anhtn1980/TNN-Smart-Control/(commit log)

2026-05-23 đưa file từ máy tính lên
2026-05-27 fix: stabilize relay status stream and parsing between ESP and Mega
    [Code_ArduinoMEGA2560_W5500_TCP_Max485_.ino, Code_ESP32_Web_UI_TCP_client_.ino]
2026-05-27 perf: reduce UI command cooldown for faster consecutive button presses
2026-05-28 fix: make relay taps smoother with optimistic state command flow
    [Code_ArduinoMEGA2560_W5500_TCP_Max485_.ino, Code_ESP32_Web_UI_TCP_client_.ino]
2026-06-18 Add initial changelog for firmware versions
    Added changelog for TNN Smart Control firmware updates, detailing improvements and version history for both Arduino MEGA and ESP32 components.
2026-06-18 Enhance HTTP request handling and firmware versioning
    Updated firmware version and improved HTTP request handling with a timeout mechanism. Adjusted reconnection frequency and delays for better stability.
    [Code_ESP32_Web_UI_TCP_client_.ino]
2026-06-20 Bump firmware version to 1.3.0 and enhance relay sync
    Updated firmware version to 1.3.0 and improved state synchronization for relay commands.
2026-06-20 Rollback changes in v1.2.0 for improved responsiveness
    Rollback changes from v1.2.0 due to issues with physical switch mirroring logic and response delays. Adjustments made to improve responsiveness and remove blocking behavior in the ESP32 web client.
2026-06-20 Bump version to 1.4.0 and fix relay button issues
    Updated version to 1.4.0 and fixed relay button responsiveness issues. Added pendingTarget tracking and improved status synchronization.
2026-06-20 Update Changelog for version 1.5.0 enhancements
    Triển khai HTTP keep-alive để cải thiện kết nối ESP32 tới MEGA. Thêm nhiều cải tiến như quản lý kết nối và xử lý yêu cầu web.
2026-06-23 them logic 4 nut dieu hoa voi LOGO
2026-06-24 feat(esp32): v2.1.0 — trang /modbus điều khiển 4 điều hòa qua LOGO! 8
    - Đổi logoPort từ 502 → 504 (port riêng cho hệ thống TNN)
    - Thêm readACFeedback(): FC1 Read Coils V0.0-V0.3 cập nhật acSnapshot
    - Thêm route GET /ac/toggle?ch=0..3: gọi logoSendPulse(), trả JSON
    - Thêm route GET /ac/status: đọc feedback thật, trả {"ac":[0,1,0,0]}
    - Thay trang /modbus placeholder bằng UI hoàn chỉnh: 4 nút ĐH1-ĐH4,
    trạng thái thật từ LOGO!, cooldown 1.6s, poll 2 giây
    Claude-Session: https://claude.ai/code/session_01GHmGa9BQc2wq6tp54nUGxA
2026-06-24 feat(esp32): v2.2.0 — trang /amx CE-IO4 + CE-REL8, cải tổ menu
    Menu:
    - Xóa trang /logo (iframe LOGO! Web Editor)
    - Đưa /modbus lên vị trí 2, đổi tên thành "Điều khiển Điều hòa (LOGO!)"
    - /amx nay có UI và backend thật
    AMX (CE-IO4 port 44197 + CE-REL8 port 44197):
    - amxMultiQuery(): connect-per-transaction, gửi nhiều lệnh, đọc nhiều dòng
    - amxReadInputs(): Subscribe /io/N/digitalInput → cập nhật amxInputSnapshot
    - amxReadRelays(): Subscribe /relay/N/state → cập nhật amxRelaySnapshot
    - amxSetRelay(ch, val): set /relay/N/state true|false + optimistic update
    - amxMirrorInputs(): khi IO thay đổi → toggle relay tương ứng (kèm mirror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
2026-06-24 config(esp32): cập nhật IP AMX thực tế
    CE-IO4 → 192.168.1.203
    CE-REL8 → 192.168.1.204
    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
2026-06-24 feat(esp32): v2.3.0 — trang KIOS, info panel, AMX mirror flag
    - Thêm trang /kios "Truy cập trang KIOS" (hàng 4)
    Trang KIOS (/kios):
    - Nhập URL + nhấn Enter hoặc ▶ Truy cập → nhúng iframe
    - Lưu URL vào localStorage (nhớ qua lần sau)
    - Preset nhanh: LOGO! Web Editor, MEGA, ESP32 Menu
    - Nút mở tab mới + tải lại
    AMX mirror flag (amxMirrorEnabled):
    - Mặc định false — Kramer đang quản lý công tắc tường (giai đoạn 1)
    - Bật/tắt qua UI nút "Bật Mirror" / "Tắt Mirror" trên trang /amx
    - Route GET /amx/mirror?enable=true|false
    - /amx/status trả thêm field mirrorEnabled
    Info panel (ℹ️ Thông tin) trên các trang:
    - /mega: ki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
2026-06-24 fix(kios): cải tổ UI trang KIOS — 3 nút site, ẩn URL bar
    - Xóa preset cũ (LOGO!/MEGA/ESP32)
    - 3 nút mới: KC-Brain (192.168.1.236:8000), SL-240C (192.168.1.215:8000),
    "＋ Nhập trang mới" (toggle URL input bar)
    - URL bar ẩn mặc định, chỉ hiện khi bấm "Nhập trang mới"
    - Mặc định mở KC-Brain khi vào trang
    - Nút 🔄 tải lại gọn trong top bar
    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
    [Code_ESP32_Web_UI_TCP_client_.ino]
2026-06-24 fix(kios): xóa dòng hint thừa về đăng nhập iframe
    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
    [Code_ESP32_Web_UI_TCP_client_.ino]
2026-06-24 fix(amx): sửa 2 bug mirror từ Codex review
    P1 — Seed amxLastInputs khi bật mirror:
    Khi chuyển amxMirrorEnabled false→true, nếu một số công tắc
    tường đang HIGH, amxLastInputs=0 khiến poll đầu tiên coi tất cả
    input đang HIGH là "thay đổi mới" và toggle relay sai.
    Fix: amxLastInputs = amxInputSnapshot ngay tại thời điểm bật.
    P2 — Đồng bộ _mirror từ server trong poll():
    Biến JS _mirror khởi tạo false cứng. Nếu server đang mirrorEnabled=true
    (qua reboot hoặc tab khác bật), lần bấm đầu tiên gửi enable=true thay vì
    enable=false, khiến không thể tắt được mirror.
    Fix: _mirror = !!d.mirrorEnabled mỗi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
    [Code_ESP32_Web_UI_TCP_client_.ino]
2026-06-24 fix(amx): ẩn info panel mặc định — thiếu display:none trong CSS
    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
    [Code_ESP32_Web_UI_TCP_client_.ino]
2026-06-24 fix(amx): bỏ AMX polling trong loop() khi mirror TẮT
    Khi amxMirrorEnabled=false (mặc định, Kramer đang chạy), amxReadInputs()
    vẫn được gọi mỗi 500ms và block 400ms chờ timeout vì AMX device chưa
    kết nối thật. Hệ quả: loop() bị chiếm ~80% thời gian, server.available()
    không được gọi kịp → ERR_CONNECTION_REFUSED khi navigate.
    Fix: chỉ poll AMX trong loop() khi amxMirrorEnabled=true. IO status vẫn
    được đọc on-demand qua /amx/status khi browser poll trang AMX.
    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
    [Code_ESP32_Web_UI_TCP_client_.ino]
2026-06-24 fix(amx): v2.4.0 — persistent connection CE-IO4, non-blocking IO poll
    Subscribe của AMX CE-IO4 không hoạt động one-shot trên connection mới
    (thiết bị chỉ push khi có thay đổi, không trả response ngay). Chuyển
    sang mô hình persistent connection:
    - amxIoClient: EthernetClient giữ lâu dài với CE-IO4
    - amxIoConnect(): connect + gửi 4 Subscribe lệnh, CE-IO4 sẽ gửi
    trạng thái hiện tại ngay rồi push mỗi khi công tắc thay đổi
    - amxIoPoll(): đọc push data trong loop(), hoàn toàn non-blocking
    (chỉ đọc bytes đang sẵn sàng, không chờ)
    - Reconnect tự động mỗi 8s nếu mất kết nối
    - /amx/status dùng cached amx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
    [Code_ESP32_Web_UI_TCP_client_.ino]
2026-06-24 refactor(amx): v2.5.0 — reconcile logic, bỏ mirror flag
    Thay "track IO change → toggle relay" bằng "IO change → đợi 500ms
    → đọc relay thật → SET nếu chưa khớp IO".
    Ưu điểm:
    - Cả Kramer và ESP32 đều SET đến cùng giá trị → không xung đột
    - Hoạt động song song không cần ngắt Kramer, không cần flag bật/tắt
    - Web button override vẫn hoạt động (không tạo IO change event)
    - Delay 500ms nhường Kramer phản hồi trước: nếu Kramer đã đúng → ESP32
    đọc relay khớp IO → không làm gì → zero unnecessary writes
    Xóa: amxMirrorEnabled, amxLastInputs, amxMirrorBlockUntil,
    amxMirrorInputs(), route /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
2026-06-24 fix: remove stale amxMirrorBlockUntil reference left after v2.5.0 refactor
    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
    [Code_ESP32_Web_UI_TCP_client_.ino]
2026-06-24 fix: correct _parseAmxIoLine prefix — CE-IO4 pushes "update /io/N/..." not "update io/N/..."
    IO dot indicators never changed color because every push line was silently
    dropped by the startsWith check missing the leading slash, and charAt offset
    was off by one.
    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
    [Code_ESP32_Web_UI_TCP_client_.ino]
2026-06-24 fix: CE-IO4 set INPUT mode before Subscribe; revert parser to no-slash format
    Driver feedback format is "update io/N/digitalInput" (no leading slash).
    CE-IO4 returns "unknown path" when port is in OUTPUT mode — send
    "set /io/N/mode INPUT" first so digitalInput path becomes valid.
    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
    [Code_ESP32_Web_UI_TCP_client_.ino]
2026-06-24 fix: switch CE-IO4 from Subscribe to polling get /io/N/digitalInput
    Subscribe returned "unknown path" — CE-IO4 manual confirms get command works:
    get /io/N/digitalInput → update /io/N/digitalInput true|false
    Poll every 800ms, init inputMode DIGITAL at setup, remove persistent connection.
    Parser updated to match leading-slash format per manual rev05 p.44.
    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
    [Code_ESP32_Web_UI_TCP_client_.ino]
2026-06-24 debug: print all raw AMX response lines in amxMultiQuery
2026-06-24 fix: correct CE-IO4 IP from 192.168.1.203 to 192.168.1.7
    [Code_ESP32_Web_UI_TCP_client_.ino]
2026-06-24 feat: wall switch triggers relay toggle instead of state mapping
    Each IO state change (either direction) queues a toggle for that relay channel.
    After 500ms delay, read actual relay state: if Kramer already toggled it, skip;
    otherwise ESP32 toggles it. Eliminates direct state mapping that caused relay
    to follow switch open/close position rather than acting as a toggle.
    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
    [Code_ESP32_Web_UI_TCP_client_.ino]
2026-06-24 docs: update DESIGN.md with AMX section, update info panel, add user manual
    - DESIGN.md: add section 6 (AMX architecture, toggle logic, protocol reference),
    update architecture diagram, device table, routes table, status section
    - /amx info panel: rewrite to reflect toggle logic (not state mapping),
    remove stale Subscribe warning, correct IO poll interval to 800ms
    - HuongDanSuDung.doc: new Word-compatible user manual covering all 4 pages,
    troubleshooting table, technician reference (IPs, ports, test commands)
    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
    [Code_ESP32_Web_UI_TCP_client_.ino]
2026-06-24 fix: seed IO snapshot at boot to prevent relay flicker on ESP32 startup
    amxInputSnapshot starts at 0; first poll saw any active switch as a change
    and triggered toggle. Fix: read IO state at init and seed the snapshot, then
    clear amxNeedsReconcile and amxPendingToggle so nothing fires on boot.
    Also reduce poll interval 800ms→400ms and reconcile delay 500ms→300ms.
    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
    [Code_ESP32_Web_UI_TCP_client_.ino]
2026-06-25 fix: reduce AMX timeout 400ms→150ms to free loop() for HTTP requests
    amxReadInputs() was blocking loop() up to 400ms every 400ms, leaving no
    time to accept web connections → ERR_CONNECTION_REFUSED. CE-IO4 responds
    in <50ms so 150ms timeout is sufficient. Poll interval raised to 600ms to
    give 450ms per cycle for web request handling.
    [Code_ESP32_Web_UI_TCP_client_.ino]
2026-06-25 ui: rename AMX relay buttons to P.Họp, P.Tuấn, K.Doanh, H.Lang
2026-06-25 fix: persistent CE-IO4 connection to stop W5500 socket exhaustion
    Root cause of ERR_CONNECTION_REFUSED: amxReadInputs() opened a new TCP
    socket every 600ms. W5500 holds closed sockets in TIME_WAIT for seconds,
    exhausting all 8 hardware sockets → new HTTP connections refused (RST).
    Fix: keep one persistent EthernetClient to CE-IO4. amxIoSendGet() sends
    get commands on existing socket; amxIoPoll() reads responses non-blocking
    every loop(). Only 1 socket used for IO polling instead of 1 per 600ms.
    Reconnect automatically if connection drops (5s timeout).
    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
    [Code_ESP32_Web_UI_TCP_client_.ino]
2026-06-25 ui: KIOS add page reload button and auto-reconnect on ESP32 recovery
    - Add separate buttons: reload iframe vs reload full page
    - Auto-ping ESP32 every 10s; if connection was lost and restored, reload
    page automatically so kiosk recovers without user touching browser chrome
2026-06-25 feat: SPA refactor — single page with tab navigation, no full reload
    - Replace 5 separate HTTP routes (/, /mega, /modbus, /amx, /kios) with
    one combined SPA route serving all pages in a single HTML response
    - Nav bar with 4 tabs: Đèn, Điều hòa, AMX, KIOS — pages show/hide via CSS
    - masterPoll() only fetches data for the active tab (saves W5500 sockets)
    - KIOS tab: iframe browser with address bar, reload/new-tab buttons
    - Fix compilation bug: remove stale `kinp &&` C++ expression prefix
    - AMX: persistent CE-IO4 connection, toggle logic, relay names updated
    - Seed IO snapshot at boot to prevent relay flicker on startup
    - DESIGN.md updated with AMX section, toggle logic, SPA archite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
    [Code_ESP32_Web_UI_TCP_client_.ino]
2026-06-25 docs: cập nhật toàn bộ tài liệu lên v2.6.0
    - README.md: viết lại hoàn chỉnh — kiến trúc SPA, bảng IP đầy đủ,
    API table, version history, mapping chân, lưu ý vận hành
    - DESIGN.md: cập nhật version v2.6.0, thêm section SPA Architecture (3.3),
    cập nhật routes table (SPA vs 5 routes cũ), fix section numbering,
    cập nhật section 6.4 (CE-IO4 persistent vs CE-REL8 per-transaction),
    cập nhật section 10 (tình trạng hoàn thiện đầy đủ)
    - Changelog.md: thêm v2.6.0 (SPA), v2.5.0 (persistent CE-IO4),
    v2.4.0 (toggle logic), v2.3.0 (polling), v2.2.0 (AMX tích hợp),
    v2.1.0 (KIOS)
    - HuongDanSuDung.doc: viết lại đầy đủ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
    [Code_ESP32_Web_UI_TCP_client_.ino]
2026-06-25 feat: thêm HTTP Basic Authentication (v2.7.0)
    Bảo vệ toàn bộ giao diện web khi mở cổng NAT ra Internet.
    - checkAuth(): kiểm tra header Authorization: Basic <Base64>
    - send401(): trả 401 + WWW-Authenticate để browser hiện login dialog
    - Áp dụng cho mọi route trước khi xử lý bất kỳ lệnh nào
    - Mặc định user/pass: tnn / tnn@2026 — đổi AUTH_USER/AUTH_PASS/AUTH_B64
    trước khi nạp firmware nếu muốn dùng credential khác
    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
2026-06-25 fix: Basic Auth chỉ hỏi password, không hỏi username (v2.7.1)
    Đổi credential từ "tnn:tnn@2026" sang ":tnn@2026" (username rỗng).
    Trình duyệt hiện 1 ô Password duy nhất — đơn giản hơn cho người dùng.
    AUTH_B64 cập nhật: Base64(":tnn@2026") = "OnRubkAyMDI2"
    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
    [Code_ESP32_Web_UI_TCP_client_.ino]
2026-06-25 feat: NTP time sync + auto-off scheduler (v2.8.0)
    - EthernetUDP NTP client: sync giờ từ 192.168.1.1 (router) lúc boot,
    re-sync mỗi 6 tiếng, retry mỗi 30s nếu chưa sync được
    - runScheduler(): kiểm tra mỗi giây, kích hoạt trong window 5 phút
    sau mốc giờ (xử lý trường hợp mất điện rồi boot lại)
    - Mặc định: tắt tất cả lúc 18:00 — sửa SCHEDULE[] để thêm/đổi mốc
    - Tắt đồng thời: 16 relay MEGA + 4 relay AMX CE-REL8 + 4 điều hòa LOGO!
    - schedFiredToday (bitmask): mỗi mốc chỉ kích hoạt 1 lần/ngày,
    reset tự động khi sang ngày mới
    - Không ảnh hưởng hiệu năng: NTP dùng 1 UDP socket ~10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
    [Code_ESP32_Web_UI_TCP_client_.ino]
2026-06-25 feat: thay Basic Auth bằng form đăng nhập chỉ có ô Password (v2.9.0)
    - Xóa hoàn toàn HTTP Basic Auth (không còn hộp thoại username/password)
    - Trang /login: form HTML tối giản chỉ có 1 ô "Mật khẩu", nền tối,
    hiện thông báo "Sai mật khẩu" nếu nhập sai
    - POST /login: kiểm tra password → set cookie sid=<token> → redirect /
    - checkCookie(): mọi request khác đều kiểm tra cookie trước khi xử lý
    - initAuthToken(): token ngẫu nhiên tạo lúc boot từ millis()
    - Fix NTP: set lastNtpAttempt sau setup() để tránh double-call trong loop()
    Claude-Session: https://claude.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
    [Code_ESP32_Web_UI_TCP_client_.ino]
2026-06-25 config: đổi mật khẩu đăng nhập thành 123456
    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
2026-06-25 chore: giảm log Serial Monitor — chỉ giữ sự kiện quan trọng
    Xóa: TX mỗi lệnh MEGA, AMX RAW mỗi 600ms, connect fail liên tục
    Giữ: boot info, IP, NTP sync, IO state change, scheduler fired
    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
    [Code_ESP32_Web_UI_TCP_client_.ino]
2026-06-25 fix: đổi NTP server sang time.google.com (216.239.35.0)
    Router 192.168.1.1 không có NTP relay — dùng IP cố định của Google
    để tránh phụ thuộc DNS.
    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
    [Code_ESP32_Web_UI_TCP_client_.ino]
2026-06-25 feat: đồng hồ thực, tab Settings, /info endpoint, nút Thoát (v3.0.0)
    Đồng hồ:
    - Hiển thị giờ thực HH:MM:SS trên nav bar, cập nhật mỗi giây qua /info
    - Không tốn socket riêng: dùng chung /info fetch với Settings
    /info endpoint:
    - JSON: firmware version, uptime, time, ntp status, scheduler config
    - Dùng để debug từ xa không cần Serial Monitor
    Tab Cài đặt (⚙️):
    - Toggle bật/tắt scheduler
    - Input giờ:phút tắt tự động
    - Lưu qua POST /settings (không cần recompile firmware)
    - Hiển thị firmware version, IP, NTP status, uptime
    Nút Thoát:
    - GET /logout: xóa cookie sid, redirect về /login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
2026-06-25 feat: lưu settings vĩnh viễn vào flash NVS (v3.0.1)
    Dùng Preferences (ESP32 NVS) để lưu scheduler config:
    - Boot: đọc sched_en, sched_h, sched_m từ flash → áp dụng ngay
    - Lưu: POST /settings → ghi NVS → tồn tại qua reboot/mất điện
    - Default (lần đầu nạp firmware): bật, 18:00
    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
    [Code_ESP32_Web_UI_TCP_client_.ino]
2026-06-25 feat(v3.0.2): password change in Settings tab + fix scheduler toggle bug
    - Add runtime authPass variable loaded from NVS (key auth_p, default 123456)
    - POST /settings: handle old_p/new_p params — validate current pass, length 4-32, save to NVS
    - Settings tab: add password change card with current/new password fields
    - Fix: loadSched() was called every 2s by masterPoll() overwriting unsaved checkbox state
    → remove loadSched() from masterPoll(); only load once on tab open via nav(4)
    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
    [Code_ESP32_Web_UI_TCP_client_.ino]
2026-06-25 docs: add CLAUDE.md — working guide for Claude Code sessions
    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
2026-06-27 fix(v3.0.7): reap CLOSE_WAIT sockets to prevent W5500 socket exhaustion
    Root cause: when a client (browser/kiosk) closes the TCP connection first,
    the W5500 socket enters CLOSE_WAIT. server.available() only returns sockets
    with incoming data, so CLOSE_WAIT sockets are never returned and never
    stop()'d — they accumulate until all 8 hardware sockets are exhausted. The
    web server can no longer accept connections (web dead) while ping still works
    (ICMP is handled in W5500 hardware, no socket needed). Required a manual ESP32
    reset to recover.
    Fix: reapDeadSockets() scans all 8 sockets every 2s and closes any stuck in
    CLOSE_WAIT (status 0x1C) with no pending data. Connection: close alone only
    h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
    [Code_ESP32_Web_UI_TCP_client_.ino]
2026-06-27 feat(v3.0.8): rename scheduler card, hide it + add tab visibility toggles
    - Rename "Tự động tắt thiết bị" card → "Hẹn giờ tắt thiết bị"
    - Move scheduler + password into a single hidden block (secret-body) revealed by
    the existing 5-tap easter egg on the "Thông tin hệ thống" header; Settings tab
    now shows only the system-info card by default
    - New hidden "Hiển thị tab" card: 4 toggles to show/hide Đèn/Điều hòa/AMX/KIOS
    nav tabs (Cài đặt always visible). Persisted in NVS key tab_vis (bitmask,
    default 0x0F). Nav bar renders per tabVisible; startup navigates to first
    visible tab
    - GET /settings adds "tabs"; POST /settings handles tabs=<bitmask>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
2026-06-27 feat(v3.0.9): easter egg 3 taps instead of 5, keep section titles when hidden
    - Reduce taps on "Thông tin hệ thống" to reveal settings: 5 -> 3
    - Keep the 3 section titles always visible (Hẹn giờ tắt thiết bị / Hiển thị tab
    / Đổi mật khẩu); only the detail content (.sdet) is toggled, so the user can
    see what sections exist. 3 taps shows/hides the details.
    Docs: Changelog, DESIGN, CLAUDE.md
    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
2026-06-27 fix(v3.1.0): stop flickering "Lỗi kết nối" on mobile + cut W5500 request load
    Root cause: the clock fetched /info every 1s while each page polled its endpoint
    every 2s. At the 2s mark both fired near-simultaneously, needing two W5500
    sockets at once (overlapping the 3s periodic megaTransact). On mobile (higher
    WiFi RTT, browser holds/opens sockets differently than desktop) a request
    occasionally failed to grab a socket, the fetch rejected, and the zero-tolerance
    catch immediately showed "Lỗi kết nối". Desktop on a faster path rarely collided.
    Fix 1 (cut load): clock now ticks locally in JS (tickClock every 1s) and only
    resyncs /info every 30s (and on entering Settings). Removes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
    [Code_ESP32_Web_UI_TCP_client_.ino]
2026-06-27 feat(v3.2.0): rename tabs + add combined "Đèn MEGA & AMX" page
    Rename tabs: Đèn→Đèn MEGA, Điều hòa→Điều hòa LOGO!, AMX→Đèn AMX.
    New combined page (nav index 4, before Settings): 16-button grid identical to
    Đèn MEGA, but 4 positions drive AMX (CE-REL8) instead of MEGA:
    pos 3→AMX ch1 (P.Họp), 10→ch2 (P.Tuấn), 7→ch3 (K.Doanh), 2→ch4 (H.Lang).
    The 4 buttons are marked data-amx and call /amx/relay; the other 12 call /cmd.
    TẮT TẤT CẢ turns off MEGA (all-off) + the 4 AMX relays.
    Performance: combined page polls sequentially — /status (cached, cheap) then
    /amx/status — so only one inbound HTTP socket at a time, avoiding W5500 socket
    contention. Zero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
    [Code_ESP32_Web_UI_TCP_client_.ino]
2026-06-27 docs: thêm tools/build-docs.py sinh HTML đọc đẹp từ .md
    Script Python tự chứa (chỉ cần python3) chuyển mọi .md ở gốc thành
    docs-html/*.html với CSS dark-theme + index.html. .md vẫn là nguồn duy nhất;
    docs-html/ là build artifact đã gitignore. Chạy: python3 tools/build-docs.py
    Claude-Session: https://claude.ai/code/session_01TCcn1gChxpwH7uNfbZsDvw
2026-06-27 chore: mỗi sketch .ino vào thư mục con cùng tên (chuẩn Arduino)
    Trước đây 2 file .ino nằm chung ở gốc repo → Arduino IDE không mở trực tiếp
    được (gộp 2 sketch, trùng setup/loop; tên thư mục không khớp tên sketch),
    buộc người dùng copy file ra ngoài → bản copy lệch khỏi git → flash nhầm bản cũ.
    Nay: Code_ESP32_Web_UI_TCP_client_/ và Code_ArduinoMEGA2560_W5500_TCP_Max485_/
    mỗi thư mục chứa đúng 1 .ino. Mở thẳng file trong repo bằng Arduino, pull là
    cập nhật ngay, không cần copy. File .md và tools/ giữ nguyên ở gốc.
    Claude-Session: https://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
2026-06-29 feat(v3.2.1): đổi thứ tự tab — Đèn M&A lên đầu, bỏ Điều hòa xuống thứ 4
    Thứ tự mới: Đèn M&A → Đèn MEGA → Đèn AMX → Điều hòa LOGO! → KIOS → Cài đặt
    Cập nhật navIcons/navNames, thứ tự page HTML, tvNames, nav() JS, masterPoll() JS, tab_vis bitmask.
2026-06-29 docs: cập nhật Changelog.md cho v3.2.1
2026-06-29 docs: cập nhật DESIGN.md cho v3.2.1 — thứ tự tab mới
